AlexisDel/Bateau-RC/README.md

# Bateau-RC (Projet ISN)
:warning: Cf le rapport pour les schémas électriques et autres précisions ! 
